Dan-Dumi/CanSat-Projects/README.md

# CanSat-Projects
A summary of my 2025 and 2026 CanSat projects. Our satellite, WeCann, is trying to achieve active satellite stabilization using a reaction wheel.
