Dan-Dumi/CanSat-Projects/2025_(WeCann)/CAD/.step/Parachute deployment module.step

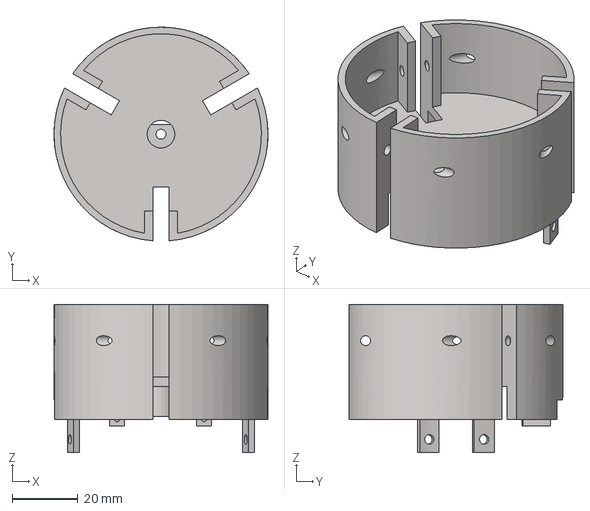
[picture p16: CAD file, 2026-04-20]
2025_(WeCann)/CAD/.step/Parachute deployment module.step
65.0 x 64.9 x 45.0 mm
