Dan-Dumi/CanSat-Projects/2025_(WeCann)/CAD/.step/Reaction wheel.step

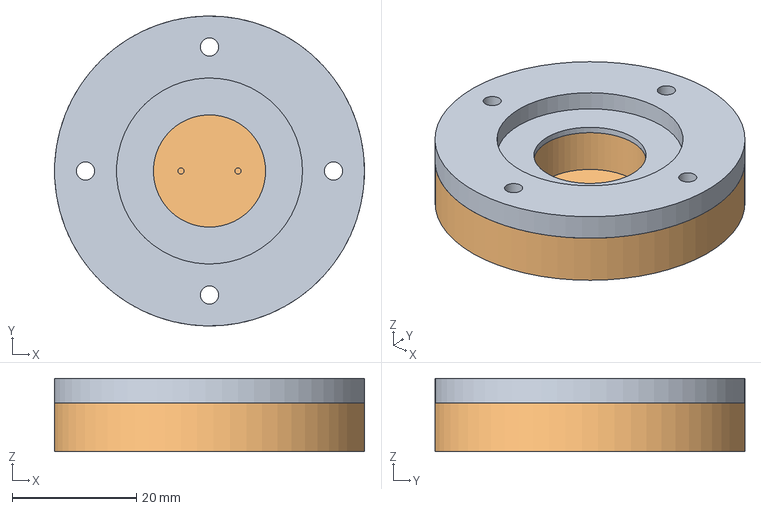
[picture p17: CAD file, 2026-04-20]
2025_(WeCann)/CAD/.step/Reaction wheel.step
50.0 x 50.0 x 11.8 mm
