Dan-Dumi/CanSat-Projects/2025_(WeCann)/CAD/.step/Shell_top.step

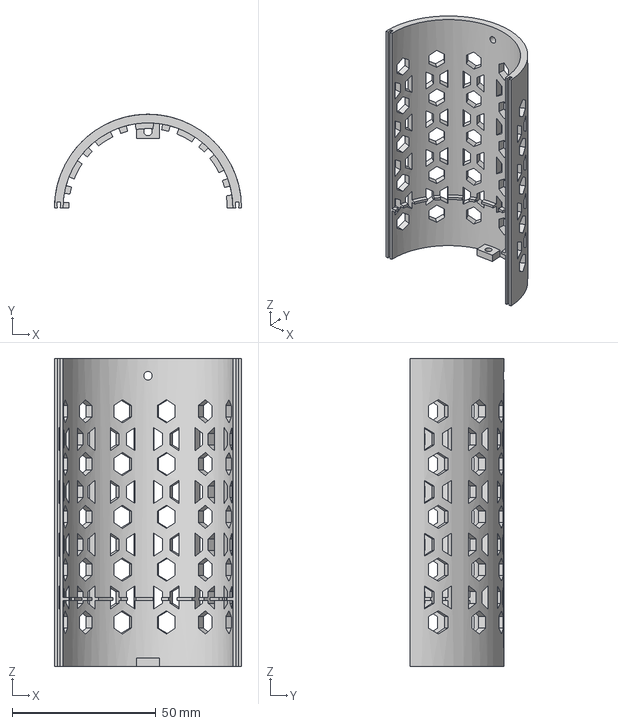
[picture p18: CAD file, 2026-04-20]
2025_(WeCann)/CAD/.step/Shell_top.step
65.0 x 32.5 x 107.0 mm
