Dan-Dumi/CanSat-Projects/2025_(WeCann)/CAD/.step/Cansat_shell_base.step

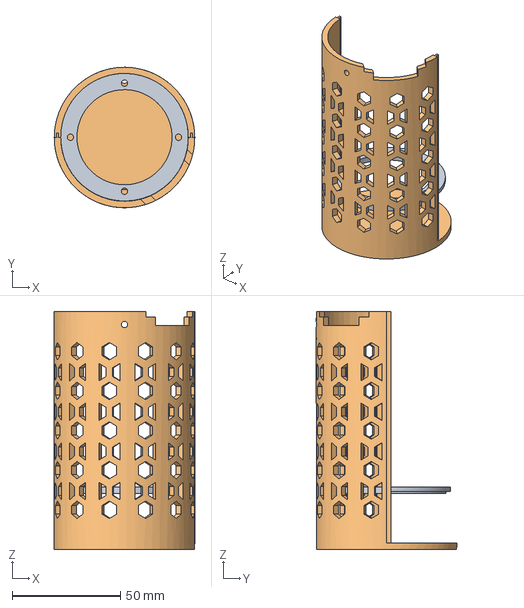
[picture p19: CAD file, 2026-04-20]
2025_(WeCann)/CAD/.step/Cansat_shell_base.step
65.0 x 65.0 x 110.1 mm
