Dan-Dumi/CanSat-Projects/2025_(WeCann)/CAD/.step/Electronic housing.step

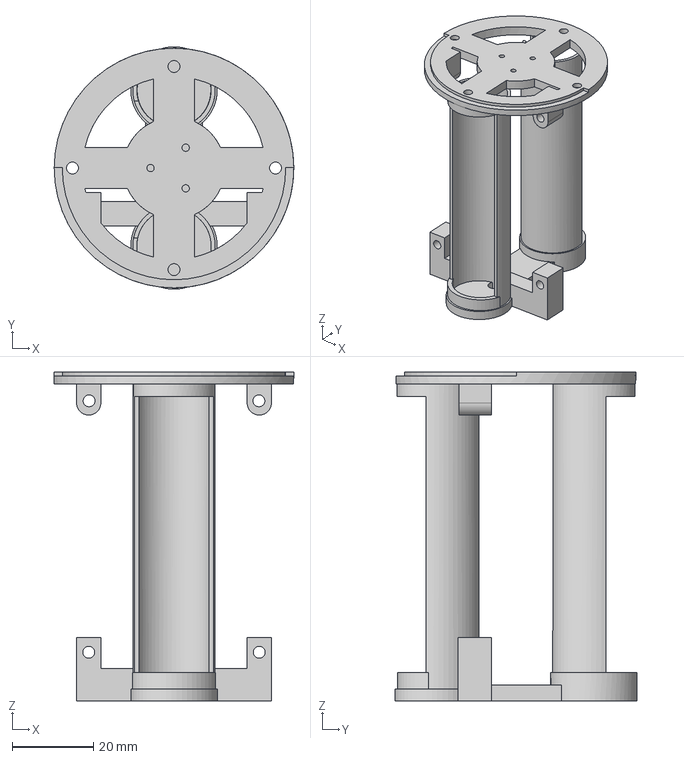
[picture p20: CAD file, 2026-04-20]
2025_(WeCann)/CAD/.step/Electronic housing.step
59.0 x 59.7 x 81.0 mm
