Dan-Dumi/CanSat-Projects/(commit log)

2026-04-20 Create CAD
    The CAD design for the first iteration of our project
2026-04-20 Create PCB
    The design of the power distribution board
